m-ghitas/wearable-hand-sensing-system/(commit log)

2026-11-11 Fix image path for glove prototype
    Updated image path for prototype in README.
2026-11-11 Add detailed sensor technology investigation section
    Expanded the sensor technology investigation section with detailed candidate evaluations for finger motion and contact-force sensing technologies. Included advantages, limitations, and decisions for each candidate sensor.
2026-11-11 Add flex sensor image to README
    Added an image of the flex sensor to the README.
2026-11-11 Update image source for flex sensor in README
2026-11-11 Fix image source for Flexible Pressure-Sensing Films
    Updated image source for Flexible Pressure-Sensing Films in README.
2026-11-11 Enhance README with links and hardware images
    Added links to prototype demonstration and images of hardware components. Updated software section to mention assistance from ChatGPT.
2026-11-11 Change hardware prototype image format to PNG
    Updated hardware image in README from JPG to PNG format.
2026-11-11 Increase image sizes for better visibility
    Updated image sizes for ESP32C3, ADS1115, and RubberPads in README.
